2025040064/Gimbal/8.目标追踪【闭环】/编码转换报告.md

# STM32 工程源码编码统一报告

- 工程：`F:\A_LIU_Astrspire\A_competition\Gimbal\STM32代码\8.目标追踪【闭环】`
- 工程文件：`MDK-ARM\LED.uvprojx`（Target：LED，Device：STM32F103C8，编译器：ARMCC V5.06 update 7 build 960）
- 处理日期：2026-10-25
- 目标：GBK/GB2312 源码 → UTF-8（无 BOM），源码与编译行为不变

## 一、结论

| 项目 | 结果 |
| --- | --- |
| 扫描 `.c`/`.h` | 705 个 |
| 纯 ASCII（无需处理） | 687 个 |
| 原本已是 UTF-8 | 0 个 |
| 含非 ASCII 字节、需判定 | 18 个 |
| 确认 GB2312 并转换为 UTF-8 | **16 个，全部成功** |
| 判定为非 GBK、按规则跳过 | 2 个（ST 官方 CMSIS 头文件，编码为 Windows-1252） |
| 编译验证 | **0 Error(s)，0 Warning(s)** |
| 固件一致性 | 生成的 `LED.hex` 与转换前 SHA-256 **完全相同** |

结论：除 2 个 ST 原始头文件外，工程内所有含中文的源码已统一为 UTF-8（无 BOM）；编译参数、工程文件、程序逻辑、固件字节均未改变。

## 二、编码判定方法

没有采用“能被 GBK 解码就算 GBK”的做法——GB18030 几乎可以解码任意字节序列。实际按以下顺序判定：

1. **UTF-8 严格解码**：能通过则视为 UTF-8，原样保留（本次为 0 个）。
2. **排除 ASCII 与 BOM**：无高位字节的文件不参与转换；检查 UTF-8 BOM / UTF-16 BOM（本次均无）。
3. **GB18030 严格解码 + GB2312 可编码性检查**：确定字节能无损映射为 GB2312/GBK 字符。
4. **多编码对照**：同一字节分别按 GB18030、Big5、Shift-JIS、EUC-KR、Windows-1252 解码，比较“常用汉字命中率”和上下文语义。
5. **语义核对**：如英文单词中间出现孤立汉字，则判为单字节西文编码而非 GBK。

常用汉字命中率对比（同一文件字节，GBK 解码 vs Big5 解码）：

| 文件 | GBK 命中常用字 | Big5 命中常用字 |
| --- | --- | --- |
| `HARDWARE\STABILIZER\stabilizer.c` | 115 | 2 |
| `HARDWARE\K230\k230.c` | 117 | 3 |
| `HARDWARE\OLED\oled.h` | 90 | 7 |
| `Core\Src\main.c` | 61 | 1 |

GBK 解码结果均为通顺中文注释（“追踪死区”“初始化”“超时检测”等），Big5 结果为无意义字符，判定为 GB2312 可信。

## 三、转换清单（16 个，全部成功）

| # | 文件（相对工程根目录） | 原编码 | 目标编码 | 字节数（原→新） | 结果 |
| --- | --- | --- | --- | --- | --- |
| 1 | `Core\Src\main.c` | GB2312 | UTF-8 无 BOM | 2660 → 2748 | 成功 |
| 2 | `Core\Src\usart.c` | GB2312 | UTF-8 无 BOM | 3278 → 3280 | 成功 |
| 3 | `HARDWARE\APP\app.c` | GB2312 | UTF-8 无 BOM | 4706 → 4753 | 成功 |
| 4 | `HARDWARE\APP\app.h` | GB2312 | UTF-8 无 BOM | 923 → 936 | 成功 |
| 5 | `HARDWARE\DWT_DELAY\dwt_delay.h` | GB2312 | UTF-8 无 BOM | 644 → 700 | 成功 |
| 6 | `HARDWARE\K230\k230.c` | GB2312 | UTF-8 无 BOM | 3459 → 3772 | 成功（5 处字符串转义，见第五节） |
| 7 | `HARDWARE\K230\k230.h` | GB2312 | UTF-8 无 BOM | 387 → 422 | 成功 |
| 8 | `HARDWARE\MORTOR\motor.c` | GB2312 | UTF-8 无 BOM | 6571 → 6621 | 成功 |
| 9 | `HARDWARE\MORTOR\motor.h` | GB2312 | UTF-8 无 BOM | 1701 → 1733 | 成功 |
| 10 | `HARDWARE\MPU6050\mpu6050.c` | GB2312 | UTF-8 无 BOM | 6090 → 6138 | 成功（1 处字符串转义） |
| 11 | `HARDWARE\MPU6050\mpu6050.h` | GB2312（仅 ± / ° 符号） | UTF-8 无 BOM | 660 → 660 | 成功 |
| 12 | `HARDWARE\OLED\bmp.h` | GB2312 | UTF-8 无 BOM | 5586 → 5600 | 成功 |
| 13 | `HARDWARE\OLED\oled.c` | GB2312 + 1 个非 GBK 字节 | UTF-8 无 BOM | 9799 → 10154 | 成功（见第五节） |
| 14 | `HARDWARE\OLED\oled.h` | GB2312 | UTF-8 无 BOM | 3161 → 3282 | 成功 |
| 15 | `HARDWARE\OLED\oledfont.h` | GB2312 | UTF-8 无 BOM | 15257 → 15290 | 成功 |
| 16 | `HARDWARE\STABILIZER\stabilizer.c` | GB2312 | UTF-8 无 BOM | 6772 → 7014 | 成功 |

说明：字节数增加来自 UTF-8 编码（1 个汉字由 2 字节变为 3 字节）以及 5 处字符串转义，字符内容本身未增删。

## 四、跳过清单（2 个，未修改）

| 文件 | 实测编码 | 依据 | 处理 |
| --- | --- | --- | --- |
| `Drivers\CMSIS\Device\ST\STM32F1xx\Include\stm32f103xb.h` | Windows-1252 | 偏移 631 处单字节 `0x92`，原文为英文 `peripheral’s registers`；按 GBK 会解成“peripheral抯”（英文中夹孤立汉字，语义不成立） | 跳过，保持原样 |
| `Drivers\CMSIS\Device\ST\STM32F1xx\Include\stm32f1xx.h` | Windows-1252 | 偏移 576、682 处各一个 `0x92`，同为 `peripheral’s` | 跳过，保持原样 |

这两个文件是 ST 官方头文件，非 GBK 编码，按“无法确认是 GBK 则报告并跳过”的要求未做改动。它们只影响编辑器显示（Keil 按 ANSI 显示为 `’`，不影响编译）；如需统一，可用 VS Code 以 Windows-1252 打开后另存为 UTF-8，请另行确认。

## 五、两处特殊处理（不改运行行为）

### 1. `oled.c` 的孤立字节 `0xA3`

该文件除第 21 行（`////...////` 注释行）末尾多出一个 `0xA3` 外，其余全部是合法 GB2312。`0xA3` 不是合法 GBK 字节，无法作为汉字的一部分；按 Windows-1252/Latin-1 该字节就是 `£`。转换时保留为 `£`（U+00A3），位于注释末尾，不影响代码与显示逻辑。`oled.h` 的同一行没有该字节，可作为对照。

### 2. 5 处中文字符串改为 `\x` 转义

涉及位置：

| 文件 | 行 | 内容（原文） |
| --- | --- | --- |
| `HARDWARE\K230\k230.c` | 40 | `printf("K230视觉模块初始化完成\r\n")` |
| `HARDWARE\K230\k230.c` | 110 | `printf("K230数据解析失败: %s\r\n", data)` |
| `HARDWARE\K230\k230.c` | 124 | `printf("K230：未检测到目标\r\n")` |
| `HARDWARE\K230\k230.c` | 126 | `printf("K230识别到目标: X=%d Y=%d W=%d H=%d\r\n", ...)` |
| `HARDWARE\MPU6050\mpu6050.c` | 149 | `printf("MPU6050陀螺仪初始化完成\r\n")` |

原因：ARMCC V5.06 按系统区域设置（GBK）解析字符串字面量。直接写入 UTF-8 中文会触发 `#870-D: invalid multibyte character sequence`，并且实测会把结尾的 `\r` 编译成字面字符（固件里变成 `5C 72 0A`，串口少一个回车）。这不是显示问题，而是真实的字节变化。

处理：把这 5 个字符串中的非 ASCII 字节写为 `\xNN` 转义，转义值取**原 GBK 字节**。例如：

```c
printf("K230\xCA\xD3\xBE\xF5\xC4\xA3\xBF\xE9\xB3\xF5\xCA\xBC\xBB\xAF\xCD\xEA\xB3\xC9\r\n");
```

结果：源码文件是合法 UTF-8；字符串编译后字节与原 GBK 完全一致；串口输出、程序体积、固件内容均不变；编译 0 警告。代价是这 5 行在源码中显示为十六进制转义，可读性下降；如需改为 UTF-8 串口输出，可再把这 5 处换成 UTF-8 字节转义（会改变串口字节，需你确认）。

## 六、校验结果

### 编码与内容

- 16 个文件全部为 UTF-8 无 BOM；705 个 `.c`/`.h` 中仅剩上述 2 个跳过文件不是 UTF-8。
- 使用独立的 Python `gbk` 编解码器做回环校验：转换后的 UTF-8 文本重新编码为 GBK，与备份的原始字节逐字节比较，16/16 一致（`oled.c` 排除该孤立字节后一致）。该步骤在字符串转义之前完成；转义只改变 5 个字符串的书写形式，其编译后字节由固件哈希一致性另行验证。
- 全文件无 U+FFFD 替换字符，无乱码；行数、CRLF 行尾数量与转换前一致（见下表）。
- 代码部分未改动：仅注释与上述 5 个字符串受影响；宏、函数、逻辑、缩进均保持原样。

| 文件 | 行尾（CRLF 数，原→新） |
| --- | --- |
| 全部 16 个文件 | 与原文件完全相同（如 `main.c` 103→103、`oled.c` 422→422、`mpu6050.c` 176→176） |

### 编译验证（原工程配置，未改任何编译选项）

| 阶段 | 结果 | Code | RO-data | RW-data | ZI-data |
| --- | --- | --- | --- | --- | --- |
| 转换前基线 | 0 Error，0 Warning | 19196 | 2588 | 168 | 1440 |
| UTF-8 原始中文字面量（中间验证） | 0 Error，**1 Warning**（`k230.c(126): #870-D`） | 19228 | 2588 | 168 | 1440 |
| 最终（字符串转义后） | **0 Error，0 Warning** | 19196 | 2588 | 168 | 1440 |

最终 `MDK-ARM\LED\LED.hex` 的 SHA-256：

```
5ec686538925e1eeefc1a347ee99ff3b0ef6fb1a87f0e22334b9eee607d7c813
```

与转换前工程中已有 `LED.hex` 的 SHA-256 完全相同，说明固件镜像字节级一致。

构建命令（与 Keil 图形界面等价，使用原 `.uvprojx`）：

```
UV4.exe -b MDK-ARM\LED.uvprojx -j0 -o build.log
```

### 改动范围

对比转换前的全工程文件哈希（855 个文件）：

- 源码改动：**仅上述 16 个 `.c`/`.h`**。
- `.uvprojx`、`.uvoptx`、`.ioc`、`.lib`、启动文件、链接脚本：**0 个改动**。
- 其余 89 个变化文件均为 `MDK-ARM\` 下的编译产物（`.o`、`.crf`、`.d`、`.lst`、`.axf`、`.hex`、`.map` 等），是编译验证的正常输出。

## 七、备份与回滚

备份目录：`_encoding_backup_20261025\`

```
_encoding_backup_20261025\
├─ files\                     # 16 个原始 GBK 文件，按原相对路径存放
├─ backup_manifest.json        # 原编码、原始 SHA-256、字节数
├─ build_01_baseline.log       # 转换前基线编译日志
├─ build_02_utf8_literals.log  # UTF-8 字面量中间验证日志（含 #870-D）
└─ build_03_final.log          # 最终编译日志（0 Error / 0 Warning）
```

回滚示例（PowerShell，在工程根目录执行）：

```powershell
Copy-Item -Recurse -Force '_encoding_backup_20261025\files\*' .
```

回滚后编译产物会因源码变化而重新编译，不影响源码。

## 八、建议

1. Keil 编辑器编码建议设为 UTF-8（`Edit → Configuration → Editor → Encoding`），这是本机设置，不会写入工程文件；否则 Keil 按 ANSI 打开 UTF-8 文件里的中文注释可能显示异常。
2. 两个 ST 头文件（`stm32f103xb.h`、`stm32f1xx.h`）如要一并统一，请确认后我再处理；它们目前不影响编译。
3. 5 处串口打印目前仍输出 GBK 字节（与原固件一致）。若希望串口助手按 UTF-8 显示，可改为 UTF-8 字节转义，固件体积会增加 35 字节，属行为变更，需你确认后再做。
