2025040064/Gimbal/docs/BOM_物资采购清单.md

# Gimbal 云台项目｜物资总表（BOM）

> 更新：2026-10-18。依据用户提供的 `wuzi.docx`（8 页物资采购清单）、仓库现有 STM32F103C8T6 HAL / K230 代码、机械文件名与 PCB/BOM 文件清单综合整理。**不代表已经采购或验证实物兼容性**。文档中的“需核实”不能直接视作缺件结论。

## 1. 项目定位与清单口径

- 项目：双轴 STM32 + K230 视觉追踪云台。
- STM32：`STM32F103C8T6`，使用 HAL；最新阶段目录为 [8.目标追踪【闭环】](../8.目标追踪【闭环】/)。
- 视觉：仓库根目录 [k230视觉云台.py](../k230视觉云台.py)，针对红色色块输出坐标，经 UART2 发送给 STM32 的 USART3。
- 执行：两路步进电机（代码采用 PUL/DIR/ENA 控制），并有摇杆手动控制和 OLED 显示。
- `wuzi.docx` 是**整机/配件采购表**；[原有 PCB BOM（xlsx）](../BOM_Board1_Schematic1_2026-10-01.xlsx) 是**电路板元件 BOM**，应逐项交叉核对，不可互相替代。由于暂未解析该 xlsx 的内部单元格，下文不会编造电阻、电容、稳压芯片等型号数量。
- 数量栏：“待定”是原 Word 未写实际装配数量，不应按图片中的商家包装选项推算。

## 2. 采购清单（保留原 Word 的 13 项）

| # | 物资 | 原清单型号/规格 | 建议核对或需求数量 | 功能/对应模块 | 依据 | 参考链接 |
|---|---|---|---|---|---|---|
| 1 | 微型轴承 | MR128ZZ，内径 8 mm / 外径 12 mm / 高 3.5 mm（截图商品选项为 10 只） | 轴承装配数待查机械图 | 云台旋转机构 | Word 第 1 页 | [原商品](https://e.tb.cn/h.RroWUt0zijFEDSQ?tk=Fm5hghltNYW) |
| 2 | OLED 显示屏 | 0.96 寸，SSD1315，I²C，商品标注 3.3 V | 1（建议；实际以接线为准） | OLED 显示 | Word 第 1 页 / `HARDWARE/OLED` | [原商品](https://e.tb.cn/h.RqGldJY3bZBwf6w?tk=HosFghAL2N5) |
| 3 | STM32 核心板 | STM32F103C8T6 | 1 | 主控 | Word 第 1–2 页 / `LED.ioc` | [原商品](https://e.tb.cn/h.RKzAZl8ee2SLyvV?tk=nfcughAJ1EJ) |
| 4 | 24 V 电源 | 24 V 锂电池，截图商品约 2200 mAh；商品标题含“25.2 伏”，须核实标称/充满电压 | 1 组（容量及接头需核实） | 电机供电候选 | Word 第 2 页 | [原商品](https://e.tb.cn/h.RI1PSwTh4Qr4gnR?tk=hybFghAJuuy) |
| 5 | 陀螺仪模块 | MPU6050 | 1 | 姿态数据采集与显示 | Word 第 2 页 / `HARDWARE/MPU6050` | [原商品](https://e.tb.cn/h.RKA14kO1djlGxI3?tk=AV25ghAHarA) |
| 6 | 双轴摇杆 | PS2 摇杆模块（带按键） | 1 | X/Y 手动控制与按键 | Word 第 3 页 / `HARDWARE/ADC` | [原商品](https://e.tb.cn/h.RI1M4UCV7uxRWnr?tk=HJcTghAGMEs) |
| 7 | AI 视觉板 | K230，原文可选不带屏幕版，视觉方案可替换 | 1 | 红色目标检测和串口输出 | Word 第 3 页 / 根目录 Python | [原商品](https://e.tb.cn/h.RqGJDC7nmrcxVBp?tk=YUAdghAFg9G) |
| 8 | Type-C 线 | USB-C 转 USB-C，原文用于 K230 供电 | 1（接口及供电端待核） | K230 供电 | Word 第 4 页 | [原商品](https://e.tb.cn/h.RqGH88OVdBqi0DS?tk=tcH7ghAEHP5) |
| 9 | A2508H 端子线 | 2.5 mm 间距，需确定 2P/3P/4P/5P | **2 根**（原文明确） | 模块接线 | Word 第 4 页 | [原商品](https://e.tb.cn/h.RI1IOhf0y0JZnSb?tk=arEZghAxHtX) |
| 10 | PH2.0 转杜邦 2.54 母端 | **4P、5P 各 1 根** | **共 2 根** | 模块连接 | Word 第 5 页 | [原商品](https://e.tb.cn/h.RJrK6XOB0c4NxsE?tk=FN8bghAz17u) |
| 11 | 法兰盘 | 铝合金法兰联轴器，原商品可选多种轴径 | 数量与轴径待核 | 两轴联轴及机械固定 | Word 第 5–6 页 | [原商品](https://e.tb.cn/h.RKASc1LYWgVWmE2?tk=qa8EghAADay) |
| 12 | 42 步进电机 | **TST42-40-40P-5**，原图标注轴径 5 mm、产品涉及闭环驱动/编码器 | **2 个** | 云台两个转轴 | Word 第 6–7 页 / `HARDWARE/MORTOR` | [原商品](https://e.tb.cn/h.RIc1SpZpb5pIc59?tk=73DhgSa5RYl) |
| 13 | 螺丝及固定件 | M3×10：24 颗；M3×16：4 颗；M3 螺母：24 颗；M3×5+6 尼龙柱：4 颗；M3×5 尼龙柱：4 颗；另有 M3 螺母：4 颗 | 按原文分别备料 | 机构及 PCB 固定，PCB 优先尼龙柱 | Word 第 7–8 页 | 原文未提供商品链接 |

> 备注：表中的 STM32、OLED 和摇杆等“建议数量”依据单套双轴系统推断；不是 Word 原文明示的采购数量。商品短链仅作来源保存，不保证仍有效、价格不变或型号恰好匹配。

## 3. 从现有仓库推导的其他必查物资（非 Word 原有条目）

| 类别 | 物资/条件 | 采购判断 | 检查依据 |
|---|---|---|---|
| 电机驱动接口 | 每轴必须有兼容 **PUL / DIR / ENA** 的控制接口；先确认 `TST42-40-40P-5` 是否已集成驱动，再决定是否需要另购 2 路外置驱动 | **先核实，避免重复购买** | [motor.c](../8.目标追踪【闭环】/HARDWARE/MORTOR/motor.c) 使用两组脉冲/方向/使能 |
| 电源转换 | 24 V 电机供电与 STM32、OLED、MPU6050、K230 所需低压供电之间的适配装置；核实输出电压、电流、模块输入范围、供电隔离及共地要求 | **待选型** | 电源清单仅有 24 V 与 Type-C 线，低压供电方案未被 Word 明确覆盖 |
| 电源辅助 | 匹配的商用电源适配器/安全保护装置、开关、合适的插头端子及线材 | **待核实** | 电源端口和整机分配方式未在 Word 中写明 |
| 程序下载/调试 | STM32 的 SWD 下载器（如现有可用 ST-LINK 则无需重复采购）、匹配调试线、电脑数据线 | **按已有工具判断** | 仓库含 `.ioc` / Keil 工程 |
| 机械部件 | [云台.step](../云台.step)、[上轴.step](../上轴.step)、[中轴承盘.step](../中轴承盘.step)、[k230支架.step](../k230支架.step)、[底盘.3mf](../底盘.3mf) 对应的实体加工件/3D 打印件 | **按机械模型清点套数** | 根目录机械文件 |
| PCB | 依据 [原理图](../原理图.pdf)、[PCB 工程（epro）](../ProPrj_云台PCB文件_10.1_2026-10-01.epro) 与 [原有电路元件 BOM](../BOM_Board1_Schematic1_2026-10-01.xlsx) 核查板材、连接器、芯片、电阻、电容等 | **必须核对电子 BOM 的具体行** | 仓库 PCB 资料；此处尚未逐单元核对 |
| K230 与 STM32 通讯 | TX/RX/GND 连接器、匹配电平；原代码设置 115200 baud；需核实 K230 具体板卡引脚与接口电压 | **待核实** | K230 `UART2` 与 STM32 `USART3` 代码 |
| 外壳/耗材 | 防松垫圈、固定支架、绝缘件等 | **按装配情况选配** | 机械装配补充推断，原 Word 未明确 |

## 4. 采购前重点核验（优先级从高到低）

1. **电机/驱动匹配**：电机名称不足以证明已集成驱动；查实际产品手册或驱动接线端子是否提供 `PUL/DIR/ENA`，并核对驱动输入电平、供电和使能逻辑。绝不能仅凭“闭环步进”四字下单外置驱动。
2. **电源一致性**：24 V 电池页面同时写有 25.2 V，应区分标称电压与充满电压；并核对 K230 板卡的 USB-C 输入规格和所有低压供电。使用匹配、带保护的成品供电设备，不直接将 24 V 加到逻辑板或 USB-C 口。
3. **机械轴径**：Word 的轴承示例内径 8 mm，步进电机示例轴径 5 mm；这不一定冲突（可通过机械轴/联轴器连接），但必须查看 STEP 具体配合尺寸与轴承座，而非按名称猜测。
4. **K230 版本/屏幕**：Python 代码当前执行 `Display.init(Display.ST7701, to_ide=True)`；如果购买无屏幕版，应确认显示初始化方式及固件是否兼容，不能默认代码原样可运行。
5. **PCB/BOM 核对**：将元件 BOM 按器件编号、封装、用量与 PCB 文件交叉比对，避免将原 Word 的整机配件表当成完整 PCB 元件表。
6. **软件与硬件版本对应**：第 8 阶段代码已手写 USART3、TIM2、ADC 等初始化，但 `LED.ioc` 中记录的外设配置主要是 USART1，重新用 CubeMX 生成代码可能覆盖或漏掉手工实现。
7. **实际闭环含义**：第 8 阶段追踪逻辑按 K230 视觉像素误差调整电机；MPU6050 代码读取姿态用于显示，但当前 `stabilizer.c` 未用 MPU6050 姿态误差闭环控制。不要把它描述为已实现完整惯性稳定云台。

## 5. 库内资源对应

| 类型 | 仓库位置 | 用途 |
|---|---|---|
| 采购原始电子元件 BOM | [BOM_Board1_Schematic1_2026-10-01.xlsx](../BOM_Board1_Schematic1_2026-10-01.xlsx) | PCB 元件级清单，**须进一步校验** |
| 原理图 | [原理图.pdf](../原理图.pdf) | 电气设计复核 |
| PCB 设计主文件 | [ProPrj_云台PCB文件_10.1_2026-10-01.epro](../ProPrj_云台PCB文件_10.1_2026-10-01.epro) | 立创 EDA 设计 |
| PCB 其他源/备份 | [云台PCB文件.eprj2](../云台PCB文件.eprj2) / [云台PCB文件.eprj_backup](../云台PCB文件.eprj_backup) | 保留旧版，不随意覆盖 |
| 机械结构 | [云台.step](../云台.step) / [底盘.3mf](../底盘.3mf) | 模型与打印/加工 |
| 完整功能版本 | [8.目标追踪【闭环】](../8.目标追踪【闭环】/) | STM32 HAL 软件 |
| K230 脚本 | [k230视觉云台.py](../k230视觉云台.py) | K230 端识别 |

## 6. 建议采购/到货状态表

采购前按此表自行确认，不将“已列出”误认成“已买到”：

| 物资组 | 型号核对 | 数量确认 | 已采购 | 到货测试 |
|---|---|---|---|---|
| 主控 + 传感 + 显示 + 摇杆 + K230 | ☐ | ☐ | ☐ | ☐ |
| 2 路电机 + 驱动接口 | ☐ | ☐ | ☐ | ☐ |
| 电源与转换/保护 | ☐ | ☐ | ☐ | ☐ |
| PCB 与元件级 BOM | ☐ | ☐ | ☐ | ☐ |
| 轴承、联轴器、打印结构件、螺丝、连接线 | ☐ | ☐ | ☐ | ☐ |

---

**来源边界**：第 2 节的规格和明确数量来自用户的 Word；第 3–4 节为结合实际代码/仓库结构得到的检查事项；原有电子 BOM 的细项尚未解析，因此没有杜撰电子元件及其采购数量。若以后在仓库加入 Word 原件，建议存入 `docs/sources/` 并在此链接。
