2025040064/Gimbal/BOM_Board1_Schematic1_2026-10-01.xlsx

No. | Quantity | Comment | Designator | Footprint | Value | Manufacturer Part | Manufacturer | Supplier Part | Supplier
1 | 4 | 100nF | C1,C2,C15,C16 | CAP-TH_L5.8-W2.4-P2.54-D0.6 | 100nF | CC1H104ZA1ED3F5P1100 | Dersonic(德尔创) | C2832506 | LCSC
2 | 2 | 470uF | C13,C14 | CAP-TH_BD10.0-P5.00-D0.6-FD | 470uF | ERG35V470M10X13 | JIERR(捷而瑞) | C47344180 | LCSC
3 | 2 | PZ254V-11-20P | CN1,CN2 | HDR-TH_20P-P2.54-V-M-4 |  | PZ254V-11-20P | XFCN(兴飞) | C22465880 | LCSC
4 | 1 | DC005 | DC1 | DC-IN-TH_DC005 |  | DC005 | SHOU HAN(首韩) | C431533 | LCSC
5 | 1 | PZ254V-11-05P | H3 | HDR-TH_5P-P2.54-V-M |  | PZ254V-11-05P | XFCN(兴飞) | C492404 | LCSC
6 | 3 | PZ254V-11-04P | H4,H8,H9 | HDR-TH_4P-P2.54-V-M |  | PZ254V-11-04P | XFCN(兴飞) | C2691448 | LCSC
7 | 1 | PZ254V-11-03P | H5 | HDR-TH_3P-P2.54-V-M_PZ254V-11-03P |  | PZ254V-11-03P | XFCN(兴飞) | C2937625 | LCSC
8 | 2 | PZ254V-11-10P | H6,H7 | HDR-TH_10P-P2.54-V-M |  | PZ254V-11-10P | XFCN(兴飞) | C492409 | LCSC
9 | 1 | 220uH | L1 | IND-TH_BD9.5-P5.20-D0.6 | 220uH | PDPTAT0810-221K | PROD(谱罗德) | C2924235 | LCSC
10 | 1 | XL-302UGD | LED3 | LED-TH_BD3.8-P2.54-FD_GREEN |  | XL-302UGD | XINGLIGHT(成兴光) | C2895476 | LCSC
11 | 1 | SS12D10G5 | P1 | SW-TH_SHOU-HAN_SS12D10G4 |  | SS12D10G5 | SHOU HAN(首韩) | C7431054 | LCSC
12 | 1 | 1kΩ | R8 | RES-TH_BD2.3-L3.7-P7.70-D0.9 | 1kΩ | CR1/8W-1K±5%-ST26 | VO(翔胜) | C2896954 | LCSC
13 | 2 | 5.1kΩ | R9,R10 | RES-TH_BD2.2-L6.5-P10.50-D0.6 | 5.1kΩ | CFR0W4J0512A50 | UNI-ROYAL(厚声) | C61298 | LCSC
14 | 1 | LCKFB-DKX-STM32F103C8T6 | U1 | CONN-TH_L53.3-W22.9_STM32F103C8T6-CARD |  | LCKFB-DKX-STM32F103C8T6 | 立创开发板 | C22396880 | LCSC
15 | 1 | AMS1117-3.3 | U2 | SOT-223-3_L6.5-W3.4-P2.30-LS7.0-BR |  | AMS1117-3.3 | AMS | C6186 | LCSC
16 | 1 | LM2596T-5.0 | U3 | TO-220-5L_L10.2-W4.5-P1.71-L |  | LM2596T-5.0 | TDSEMIC(拓电半导体) | C42421963 | LCSC
17 | 1 | 1N5825 | U4 | DO-201AD_BD5.0-L9.0-P13.00-D1.0 |  | 1N5825 | SUNMATE(森美特) | C5338483 | LCSC
18 | 4 | R30-1000602-Harwin | U5,U6,U7,U8 | SMD_BD5.0-D3.0 |  | R30-1000602-Harwin | Harwin | C47018769 | LCSC
19 | 1 | TYPE-C 6P | USB1 | TYPE-C-SMD_TYPE-C-6P_1 |  | TYPE-C 6P | SHOU HAN(首韩) | C456012 | LCSC
