2025040064/Gimbal/中轴承盘.step

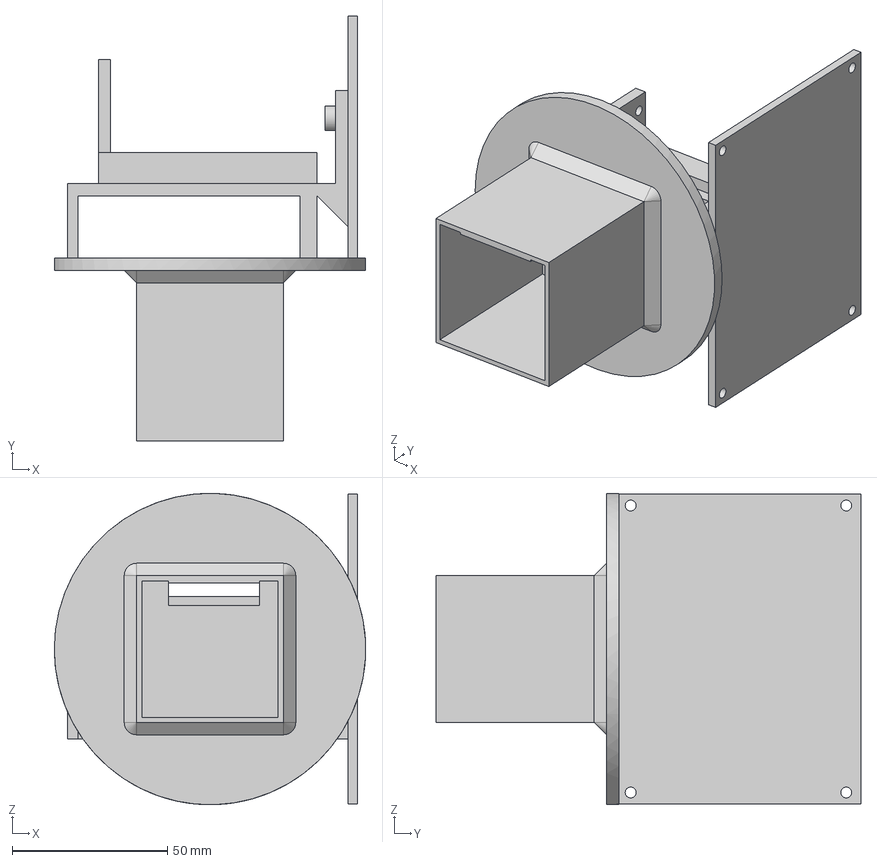
[picture p1: CAD file, 2026-10-23]
中轴承盘.step
100.4 x 137.0 x 100.4 mm
