2025040064/Gimbal/1.OLED显示/Core/Inc/main.h

#define LED_Pin GPIO_PIN_13
#define LED_GPIO_Port GPIOC
#define OLED_SDA_Pin GPIO_PIN_12
#define OLED_SDA_GPIO_Port GPIOB
#define KEY2_Pin GPIO_PIN_12
#define KEY2_GPIO_Port GPIOA
#define KEY2_EXTI_IRQn EXTI15_10_IRQn
#define OLED_SCL_Pin GPIO_PIN_15
#define OLED_SCL_GPIO_Port GPIOA
#define KEY1_Pin GPIO_PIN_4
#define KEY1_GPIO_Port GPIOB
#define KEY1_EXTI_IRQn EXTI4_IRQn
