2025040064/Gimbal/8.目标追踪【闭环】/HARDWARE/K230/k230.h

#ifndef __K230_H__
#define __K230_H__

#include "main.h"

// 对外暴露的解析结果
extern int16_t target_x;
extern int16_t target_y;
extern int16_t target_w;
extern int16_t target_h;

/* 屏幕尺寸，用于计算图像中心 */
extern int16_t screen_w;
extern int16_t screen_h;

// 对外暴露的初始化和处理函数
void K230_Init(void);
/* 返回 1 表示有新坐标或目标状态变为无效。 */
uint8_t K230_Process(void);
uint8_t K230_TargetIsFresh(void);

#endif /* __K230_H__ */
