2025040064/Gimbal/7.目标追踪【开环】/HARDWARE/STABILIZER/stabilizer.h

#ifndef __STABILIZER_H
#define __STABILIZER_H

#include "main.h"

extern uint16_t motor1_delay_display;
extern uint16_t motor2_delay_display;

void Stabilizer_Init(void);
void Stabilizer_Update(void);

#endif
