2025040064/Gimbal/(commit log)

2026-10-01 第一次提交，初版
2026-10-10 修改云台底座
2026-10-18 docs: add consolidated hardware procurement BOM and verification checklist
2026-10-23 删除重复代码
2026-11-05 第一次修改k230识别
2026-11-05 k230修改（未实机）
2026-11-05 utf8-t重新编码
2026-11-07 提交oled修改
2026-11-12 云台追踪部分的优化
