2025040064/Gimbal/(notices)

Notices in the files:
8.目标追踪【闭环】/Core/Inc/main.h:
Copyright (c) 2022 STMicroelectronics.
All rights reserved.
This software is licensed under terms that can be found in the LICENSE file
